GrandDukeX/Wireless-Arduino-Thermostat/README.md

# Wireless-Arduino-Thermostat
# Refer to the README_Microcontroller_Design_Plan docx file
# for a comprehensive overview of the project
